amal-joy-eee/forward-converter-design/efficiency.jpg

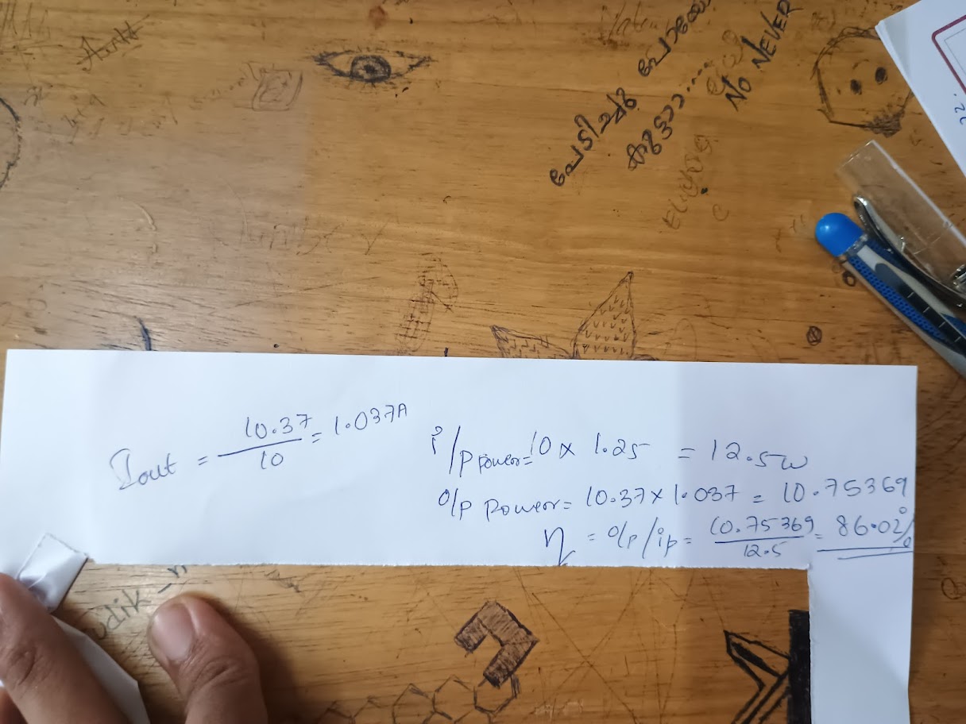
efficiency.jpg
