amal-joy-eee/forward-converter-design/output voltage on multimeter.jpg

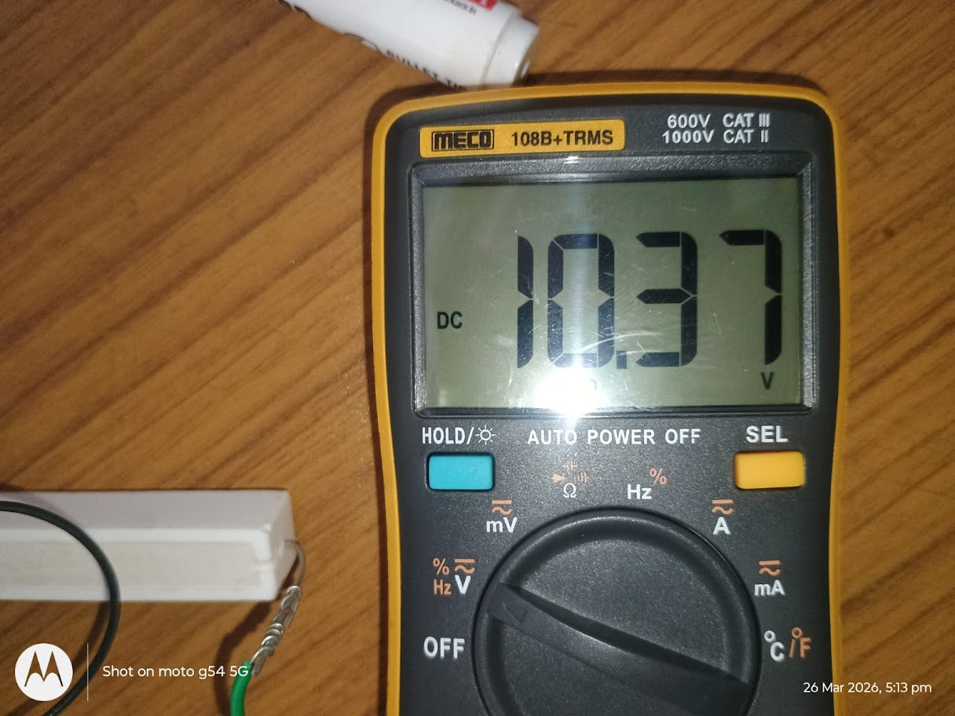
output voltage on multimeter.jpg
