amal-joy-eee/forward-converter-design/honours final  project report Amal 72.pdf

# FORWARD CONVERTER

# DESIGN AND IMPLEMENTATION

## COURSE PROJECT REPORT HNEET409 ANALYSIS OF POWER CONVERTERS

### Submitted by

## Amal Joy Reg No: LTCR24EE142

to

the APJ Abdul Kalam Technological University in partial fulfillment of the requirements for the award of the degree of

Bachelor of Technology in
Electrical and Electronics Engineering

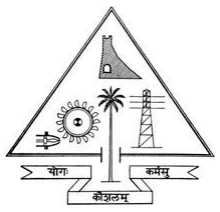
[picture p3: figure]

### Department of Electrical and Electronics Engineering

### Government Engineering College, Thrissur

### MARCH 2026 DEPARTMENT OF ELECTRICAL ENGINEERING

### GOVERNMENT ENGINEERING COLLEGE, THRISSUR

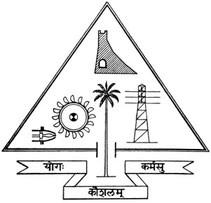
[picture p4: figure]

# CERTIFICATE

### This is to certify that the report entitled “Forward Converter Design and

### Implementation” submitted by Amal Joy (LTCR24EE142) to the APJ

### Abdul Kalam Technological University in partial fulfillment of the requirements for the award of the degree of Bachelor of Technology in

### Electrical and Electronics Engineering is a bonafide record of the project

work carried out under my guidance and supervision.

## This report has not been submitted to any other University or

Institute for any purpose.

ii

## Project Guide Dr. Nakula Narayanan Assistant Professor Dept. of Electrical and Electronics Engineering GEC Thrissur

# ACKNOWLEDGEMENT

## I would like to express my sincere gratitude to the Department of

## Electrical and Electronics Engineering, Government Engineering

## College, Thrissur, for providing me the opportunity to undertake this

## project as part of the course HNEET409 – Analysis of Power

Converters.

## I extend my heartfelt thanks to Dr. Nakula Narayanan, Assistant

## Professor, for his valuable guidance, constant encouragement, and

technical support throughout the project.

## I also thank all faculty members, my friends, and my family for their

support and encouragement.

## 1 Abstract

This report presents the design, simulation, and hardware implementation of a forward converter. The converter is designed to step up an input voltage of 10 V to an output voltage of 15 V with a load resistance of 10 Ω. The design includes transformer design using an EE42/21/15 ferrite core, output filter design, and control using the TL494 PWM controller.
The converter operates at a switching frequency of 10 kHz. A reset winding is employed in the transformer to ensure proper demagnetization of the core, eliminating the need for a snubber circuit. The transformer and output inductor are designed based on practical constraints such as core area, current density, and window utilization.
The complete circuit is simulated using LTspice, and the performance is verified under steady-state conditions. The practical implementation is carried out on a dot board, and key waveforms such as switching frequency, duty cycle, and transformer voltages are verified using a Digital Storage Oscilloscope (DSO).
The experimental results show an output voltage close to the expected value, with minor deviations due to practical non-idealities such as winding resistance, leakage inductance, and component losses. The converter operates at a duty cycle of approximately 38
A comparison between simulation (with practical component values) and hardware results shows good agreement, validating the design approach. The project demonstrates the practical realization of a forward converter and highlights the impact of non-idealities in real-world power electronic systems.

## Contents

1 Abstract | 1
2 Specifications | 4
3 Design Calculations | 4
4 Transformer Design | 5
5 Output Inductor Design | 8
6 Component Selection with Justification | 11

7 Control Circuit | 12
8 LTspice Simulation | 12
9 Hardware Implementation on breadboard | 14
10 Results and Discussion-simulation based | 15
11 Final Hardware Implementation | 15
12 Conclusion | 20

## 2 Specifications

Input Voltage | 10 V
Output Voltage | 15 V
Load Resistance | 10 Ω
Switching Frequency | 10 kHz
Turns Ratio | 1:4
Magnetizing Inductance 1 mH Output Ripple Limit 1%

## 3 Design Calculations

### 3.1 Output Parameters

Io =

Vo
R

=

15
10
= 1.5 A | (1)
Po = Vo × Io = 22.5 W | (2)

### 3.2 Duty Cycle

Vo = D · n · Vin | (3)
15 = D · 4 · 10 | (4)
D = 0.375 | (5)

### 3.3 Output Inductor Design

Assuming 20% ripple current:

∆IL = 0.3 A | (6)

Lo =

Vo(1 − D)
∆ILfs

(7)

=

15(1 − 0.375)
0.3 × 10⁴

(8)

= 3.125 mH | (9)

### 3.4 Output Capacitor Design

Co =

∆IL
8fs∆Vo

(10)

Co =

0.3
8 × 10⁴ × 0.15

=

0.3
12000
= 25, µF | (11)

A capacitor of 470, µF was used in the hardware implementation, as it was readily available. The higher capacitance helps in further reducing the output voltage ripple.

### 3.5 Magnetizing Current

Im =

VinD

Lmfs

(12)

=

10 × 0.375
1 × 10⁻³ × 10⁴

(13)

= 0.375 A | (14)

## 4 Transformer Design

The transformer is designed for a forward converter to operate safely up to a maximum duty cycle of 50%, ensuring that the core does not saturate under worst-case conditions. The design satisfies constraints on flux density, current density, and window utilization.

### 4.1 Core Selection

Core used: EE42/21/15 ferrite core.

### 4.2 Given Specifications

- Input voltage: Vin = 10 V
- Output voltage: Vo = 15 V
- Output current: Io ≈ 1.5 A
- Switching frequency: fs = 10 kHz
- Maximum duty cycle: Dmax = 0.5
- Core: EE42/21/15 ferrite core

– Effective core area: Ae = 180 mm² = 180 × 10⁻⁶ m² – Window area: Aw = 276 mm²

- Maximum flux density: Bm = 0.2 T
- Current density: J = 3.5 A/mm

2

- Window utilization factor: kw = 0.2
- Turns ratio: Ns/Np = 4

### 4.3 Design Calculations

4.3.1 1. Primary Turns

Np =

VinDmax

BmAefs

(15)

Np =

10 × 0.5
0.2 × 180 × 10⁻⁶ × 10⁴
≈ 13.89 | (16)

Np = 14 turns

4.3.2 2. Secondary Turns

Ns = 4 × Np = 56 turns

4.3.3 3. Reset Winding

Nr = Np = 14 turns

4.3.4 4. Flux Density Check

B =

VinDmax

NpAefs

(17)

B =

10 × 0.5
14 × 180 × 10⁻⁶ × 10⁴
≈ 0.198 T | (18)

B < 0.2 T (Safe)

4.3.5 5. Current and Wire Selection

The required conductor cross-sectional area is given by:

aw =

Irms
J

(19)

Primary Winding

Ip,rms = 5.1012 A (Primary RMS Current @ 50% Duty Cycle -from Ltspice simulation) (20)

awp =

5.1012
3.5

≈ 1.457 mm²
(21)

For 22 SWG wire:

aswg 22 = 0.396 mm²
(bare conductor area) | (22)

ap = 4 × 0.396 = 1.584 mm² (23)

1.584 mm² > 1.457 mm²
(Satisfies)
Ip,max = 4 × 1.57 = 6.28 A | (24)

5.1012 A < 6.28 A (Safe)

Secondary Winding

Is,rms = 1.23 A (Secondary RMS Current @ 50% Duty Cycle-from Ltspice simulation) (25)

aws =

1.23
3.5

≈ 0.351 mm²
(26)

as = 0.396 mm²
(27)

0.396 mm² > 0.351 mm²
(Satisfies)

1.23 A < 1.57 A (Safe)

Reset Winding
aswg 25 = 0.203 mm²
(bare conductor area) | (28)
aswg 25 = ar | (29)

Ir,rms = 0.1176 A (Reset Winding RMS Current @ 50% Duty Cycle-from Ltspice simulation) (30)

awr =

0.1176
3.5

≈ 0.0336 mm²
(31)

ar = 0.203 mm²
(32)

0.203 mm² ≫ 0.0336 mm²
(Safe)

0.1176 A < 0.8 A (Safe)

### 4.3.6 Wire Selection

- Primary: 4 × 22 SWG (litz equivalent)
- Secondary: 22 SWG
- Reset: 25 SWG (bifilar)

4.3.7 6. Window Utilization Check

Acu = Npap + Nsas + Nrar | (33)
Acu = (14 × 1.584) + (56 × 0.396) + (14 × 0.203) | (34)

Acu = 22.176 + 22.176 + 2.842 ≈ 47.19 mm²
(35)

Awkw = 276 × 0.2 = 55.2 mm²
(36)

47.19 < 55.2 (Winding fits)

### 4.4 Final Design Summary

Parameter | Value
Core Primary turns Secondary turns Reset turns Turns ratio Flux density Primary wire Secondary wire Reset wire | EE42/21/15 14 turns 56 turns 14 turns 1:4 0.198 T 4 × 22 SWG 22 SWG 25 SWG (bifilar)

### 4.5 Design Remarks

The transformer is designed for a maximum duty cycle of 50% to ensure safe operation under worst-case conditions. The selected number of primary turns limits the flux density below 0.2 T, preventing core saturation.
The conductor sizes are selected based on a current density of 3.5 A/mm

2
, and all
windings satisfy this criterion. Manufacturer current ratings further confirm safe operation under maximum load.
The transformer is implemented without an air-gap, as it is intended for energy transfer. The reset winding ensures proper demagnetization of the core. The window utilization confirms that the winding arrangement is physically realizable.

### 4.6 Practical Implementation and Observations

The primary turns were increased to 17 to obtain a primary inductance of 1.01 mH. For a turns ratio of 1:4, 68 turns were required on the secondary. However, due to window area limitation, only 63 turns could be wound, resulting in a measured secondary inductance of 9.34 mH.
The reset winding was implemented using bifilar winding with the primary, ensuring equal inductance and proper core demagnetization.
Winding | Turns | Measured Inductance
Primary Secondary Reset | 17 63 17 | 1.01 mH 9.34 mH 1.01 mH

Table 1: Practical Winding Details

## 5 Output Inductor Design

The output inductor is designed to meet the required inductance while satisfying constraints on flux density, current density, and window utilization.

### 5.1 Given Specifications

- Inductance: L = 3.125 mH
- RMS current: Irms = 1.3175 A
- Peak current: Im = 1.5 A
- Core: E42/21/15 ferrite core

– Effective core area: Ae = 180 mm²

– Window area: Aw = 276 mm²

- Maximum flux density: Bm = 0.25 T
- Wire used: 2 strands of 22 SWG (litz equivalent)

– Single strand area: 0.326 mm²

– Effective copper area: aw = 0.652 mm²

- Maximum current density: J < 3.5 A/mm

2

- Maximum window fill factor: kw ≤ 0.3
- Relative permeability: µr = 2200
- Permeability of free space: µ0 = 4π × 10⁻⁷ H/m

### 5.2 Design Calculations

### 5.2.1 Number of Turns

N =

LIm

BmAe

(37)

N =

3.125 × 10⁻³ × 1.5
0.25 × 180 × 10⁻⁶
≈ 104.17 | (38)

N = 105 turns

### 5.2.2 Air-gap Length

lg =

µ0N²Ae
L

(39)

lg =

4π × 10⁻⁷ × (105)² × 180 × 10⁻⁶ 3.125 × 10⁻³

≈ 0.80 mm | (40)

lg ≈ 0.80 mm

### 5.2.3 Window Fill Factor

kw =

N aw
Aw

(41)

kw =

105 × 0.652
276
≈ 0.248 | (42)

kw < 0.3 (Satisfied)

### 5.2.4 Current Density

J =

Irms
aw

(43)

J =

1.3175
0.652

≈ 2.02 A/mm

2
(44)

J < 3.5 (Satisfied)

### 5.2.5 Fringing Condition

p
Ae =

√
180 ≈ 13.4 mm

lg = 0.80 mm ≪ 13.4 mm

### 5.2.6 Reluctance Condition

0.065 mm ≪ 0.80 mm

### 5.3 Final Design Summary

Parameter | Value
Inductance Number of turns Air-gap length Core Wire Effective copper area Fill factor Current density | 3.125 mH 105 turns 0.80 mm E42/21/15 2 × 22 SWG 0.652 mm² 0.248 2.02 A/mm²

### 5.4 Practical Implementation and Observations

The inductor was practically wound with a total of 107 turns arranged in 5 layers. Due to practical limitations, the air-gap was not set with high precision. As a result, the measured inductance of the output inductor was approximately 4.67 mH, which is higher than the designed value of 3.125 mH.
Since a higher inductance results in reduced output current ripple in the forward converter, the obtained value is acceptable and does not adversely affect the performance. Therefore, the designed inductor was retained without further modification.

## 6 Component Selection with Justification

### 6.1 Switch (MOSFET)

Device used: IRF540N
The IRF540N MOSFET is selected due to its high current handling capability and sufficient voltage rating (100 V), making it suitable for low-voltage, high-current applications. It also offers low ON resistance, reducing conduction losses.

### 6.2 Diode

Device used: MBR20100CT (Schottky diode)
A Schottky diode is chosen due to its low forward voltage drop and fast switching characteristics. This improves efficiency and reduces switching losses in the converter.

### 6.3 Output Capacitor

Value used: 470 µF
The capacitor value is selected higher than the calculated minimum (375 µF) to ensure that the output voltage ripple remains within 1% under practical conditions.

### 6.4 Output Inductor

Value designed: 3.125 mH
pratical obtained value:4.37mH
The inductor is designed to limit the ripple current to 20% of the load current, ensuring continuous conduction mode (CCM) and reduced output voltage ripple.

### 6.5 Transformer Core

Core used: EE42/21/15 ferrite core
The EE42 core is selected for its adequate power handling capability ( 20–50 W range) and suitability for operation at 10 kHz with low core losses.

### 6.6 Winding Strategy

- Primary winding uses multiple parallel wires (litz equivalent) to reduce skin effect losses at switching frequency.
- Bifilar winding is used for the reset winding to ensure tight coupling and effective core reset.
- Secondary uses thicker wire to handle higher current.

### 6.7 Controller

Device used: TL494 PWM controller
The TL494 is selected due to its built-in oscillator, error amplifier, and PWM control features, making it suitable for fixed-frequency switching applications.

### 6.8 Load Resistor

Value: 10 Ω, 20 W
The resistor is rated higher than the calculated power dissipation (22.5 W peak handling considered) to ensure safe operation and thermal reliability.

## 7 Control Circuit

PWM controller used: TL494
Switching frequency set to 10 kHz.

### 7.1 schematic of TL494 circuit

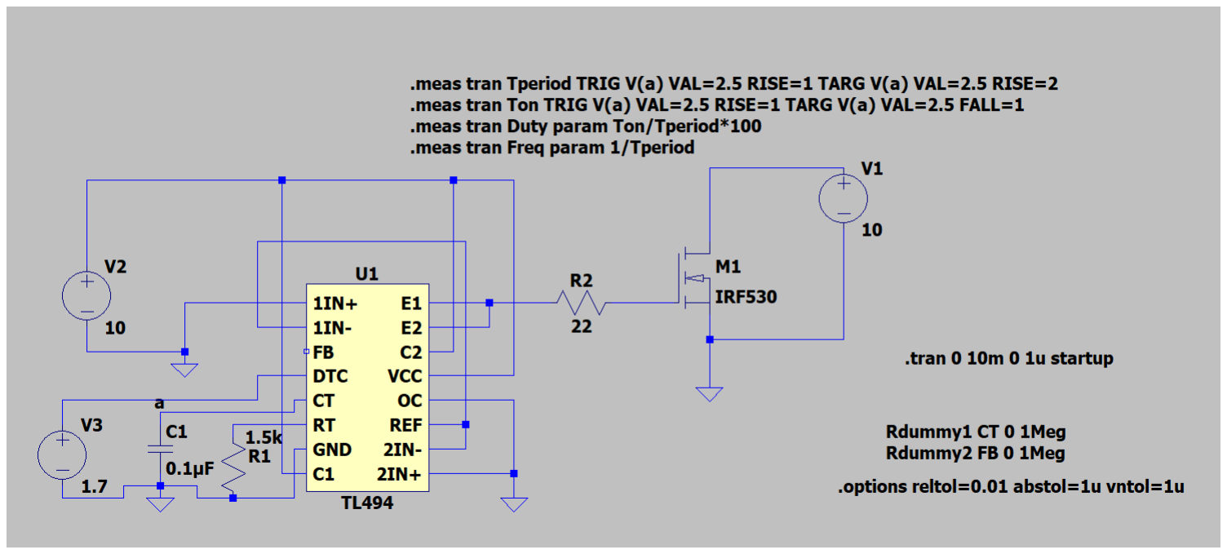
[picture p5: figure]

Figure 1: reference circuit for pulse generation

## 8 LTspice Simulation

### 8.1 Circuit Diagram

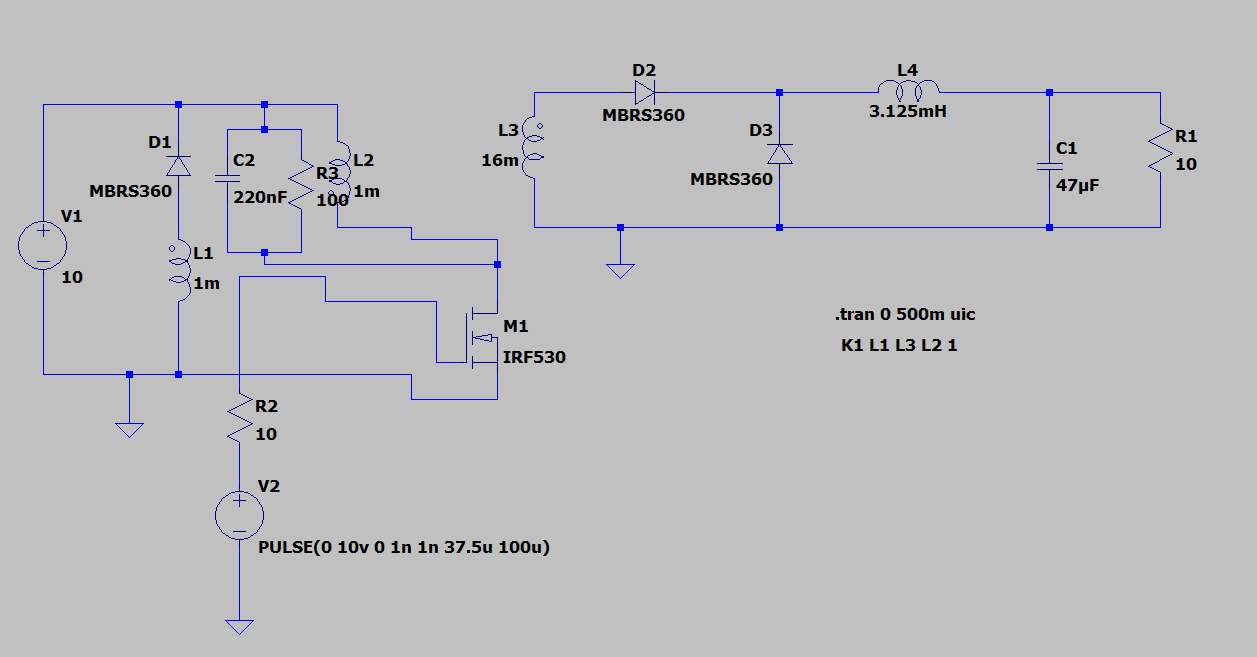
[picture p6: figure]

Figure 2: LTspice Schematic

### 8.2 Output Voltage

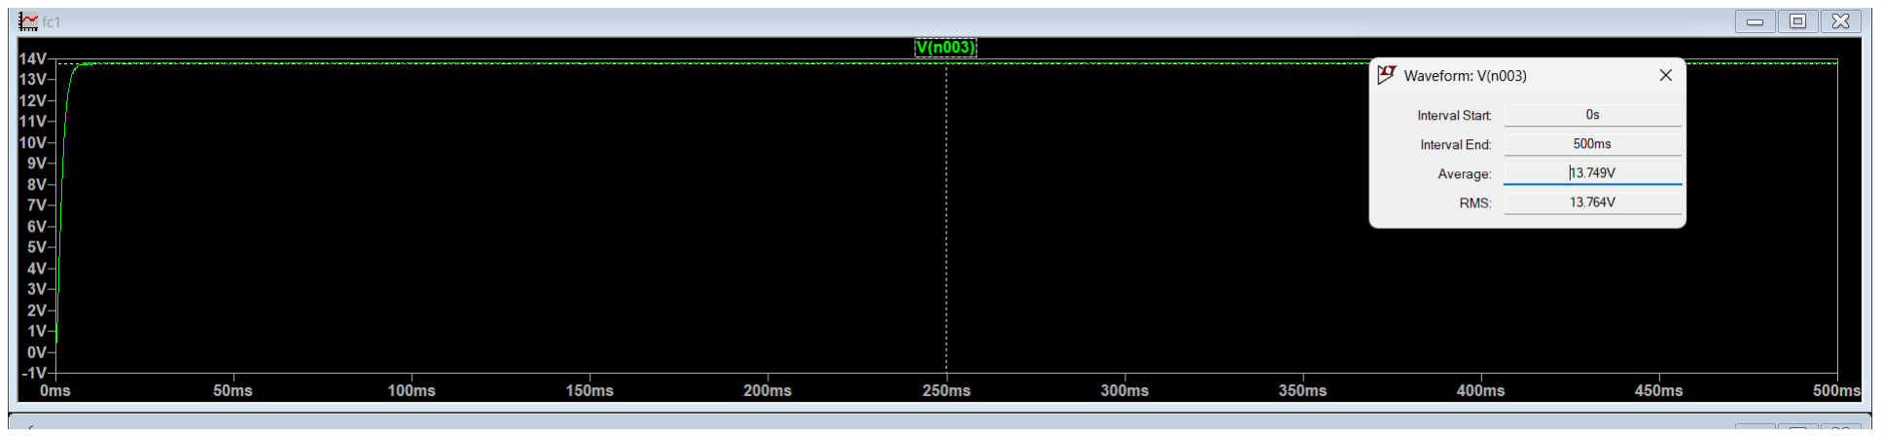
[picture p7: figure]

Figure 3: Output Voltage

### 8.3 Output Ripple

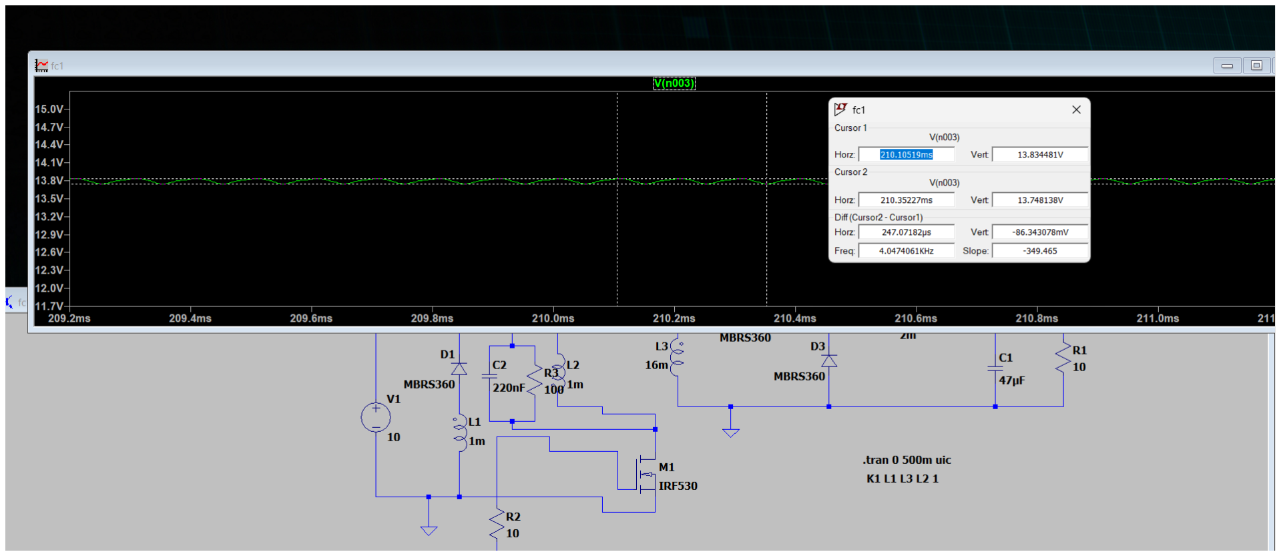
[picture p8: figure]

Figure 4: Output Ripple

### 8.4 Inductor Current

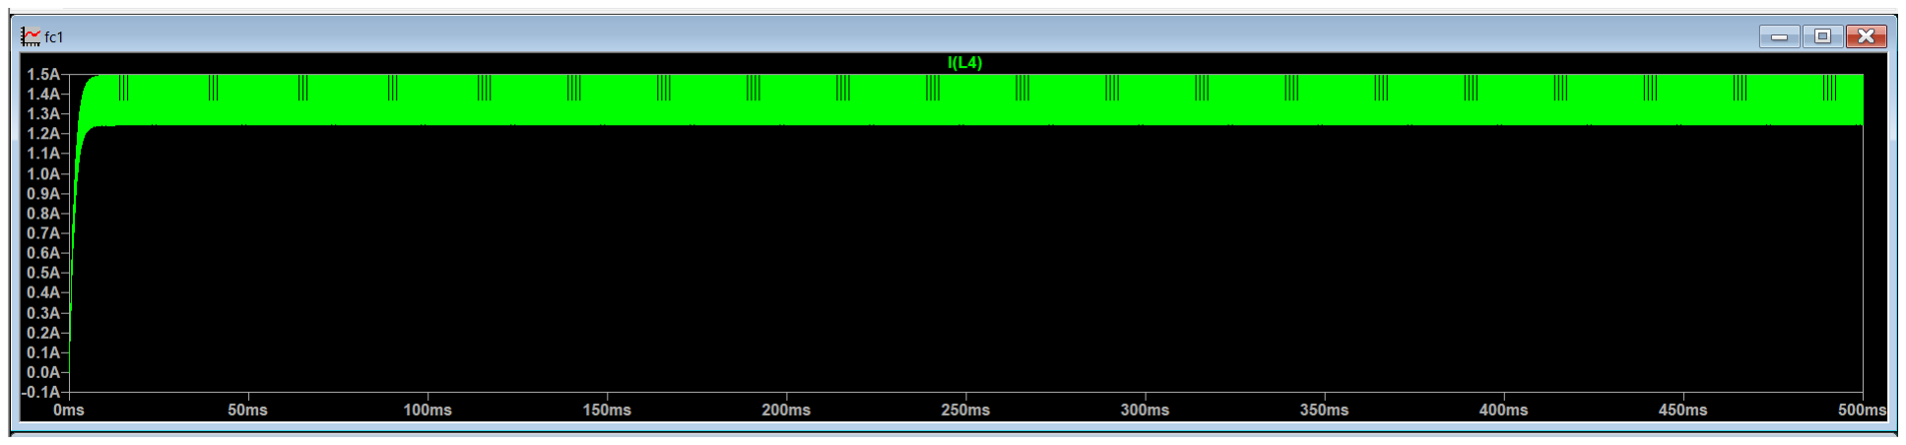
[picture p9: figure]

Figure 5: Inductor Current

### 8.5 inductor Ripple

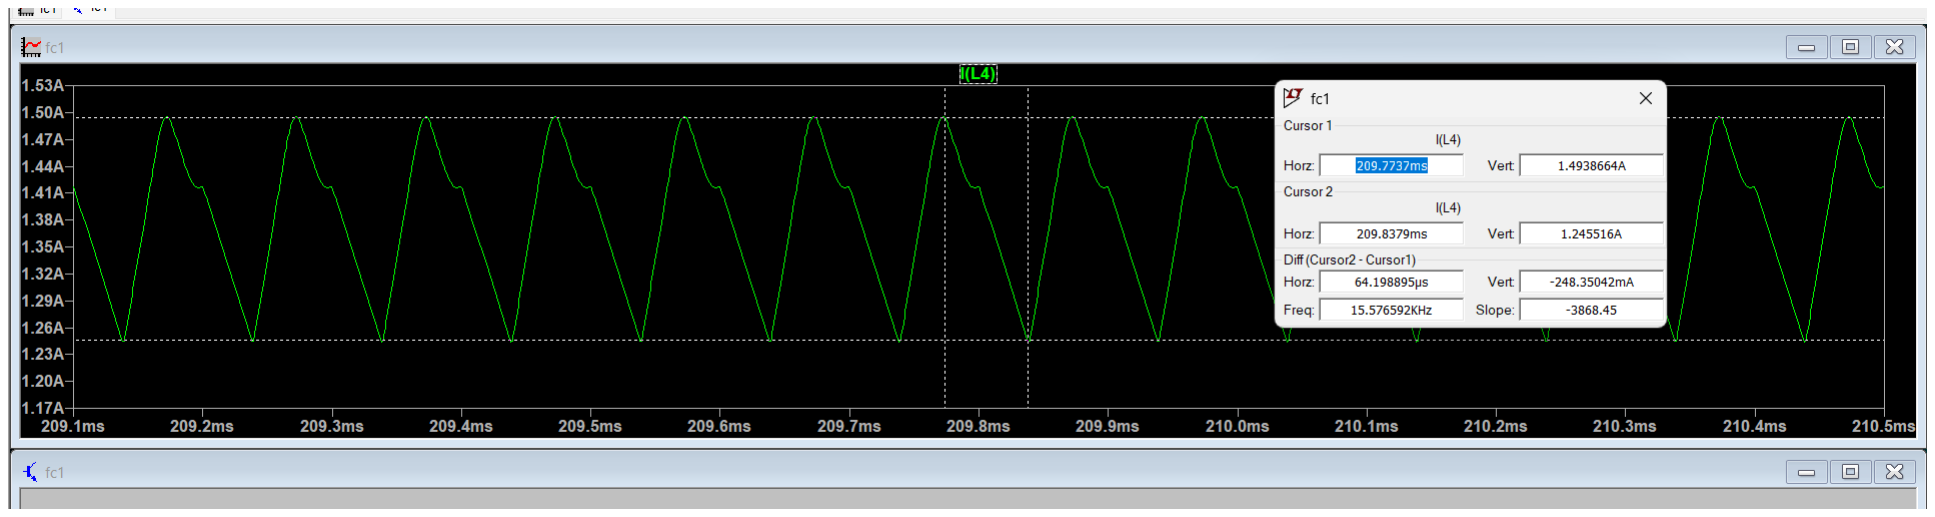
[picture p10: figure]

Figure 6: inductor Ripple

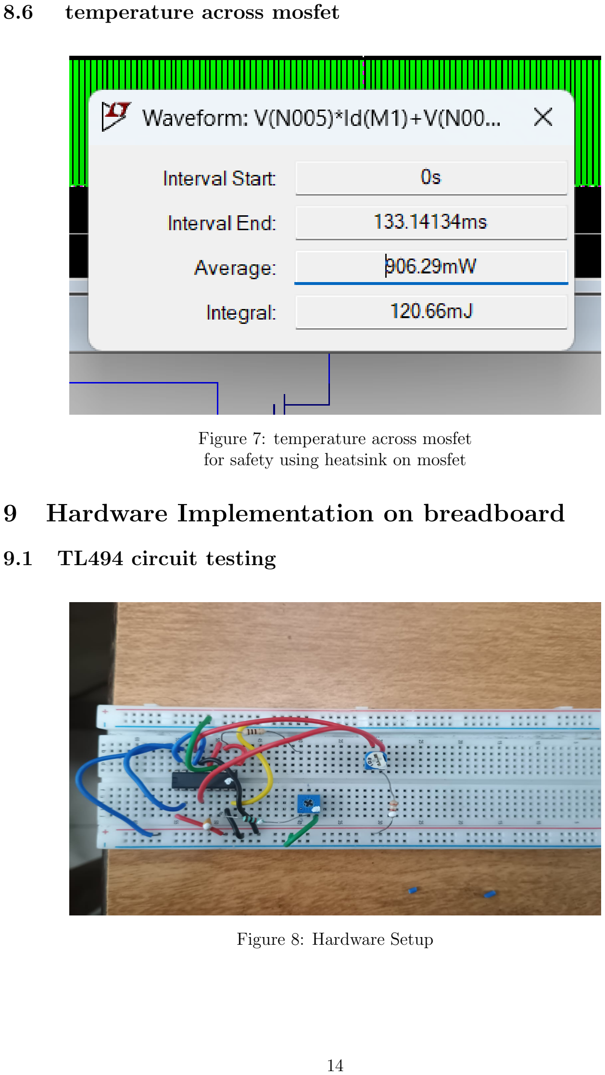
[picture p11: page 17]

### 8.6 temperature across mosfet

Figure 7: temperature across mosfet for safety using heatsink on mosfet

## 9 Hardware Implementation on breadboard

### 9.1 TL494 circuit testing

Figure 8: Hardware Setup

### 9.2 DSO Waveforms

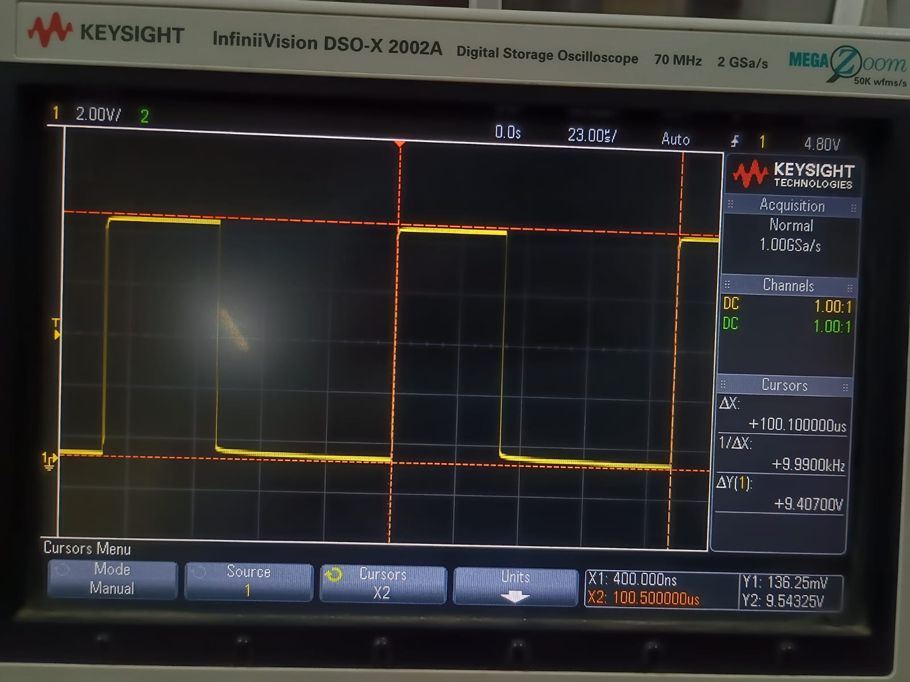
[picture p12: figure]
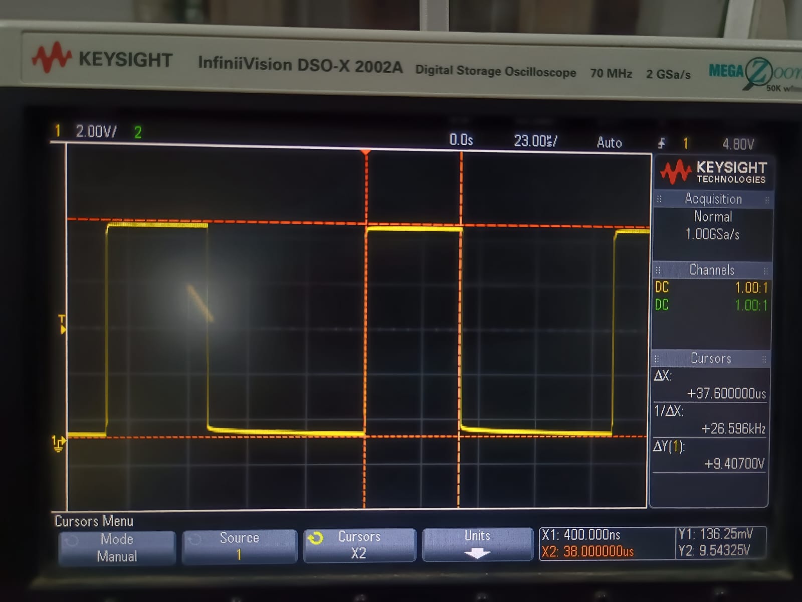
[picture p13: figure]

(a) Waveform 1 | (b) Waveform 2

Figure 9: Experimental Waveforms

## 10 Results and Discussion-simulation based

- Output voltage obtained is approximately 15 V.
- Ripple is within the 1% design limit.
- Transformer reset is successful using reset winding.
- Minor deviations due to non-ideal components and leakage inductance.

## 11 Final Hardware Implementation

### 11.1 Forward Converter Prototype

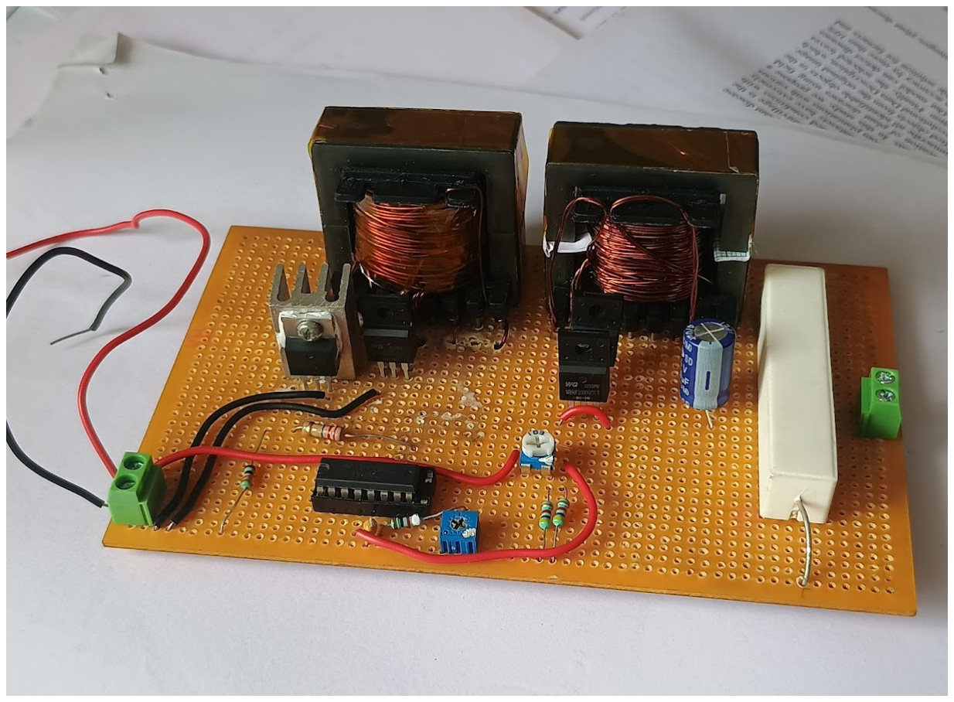
[picture p14: figure]

Figure 10: Front View

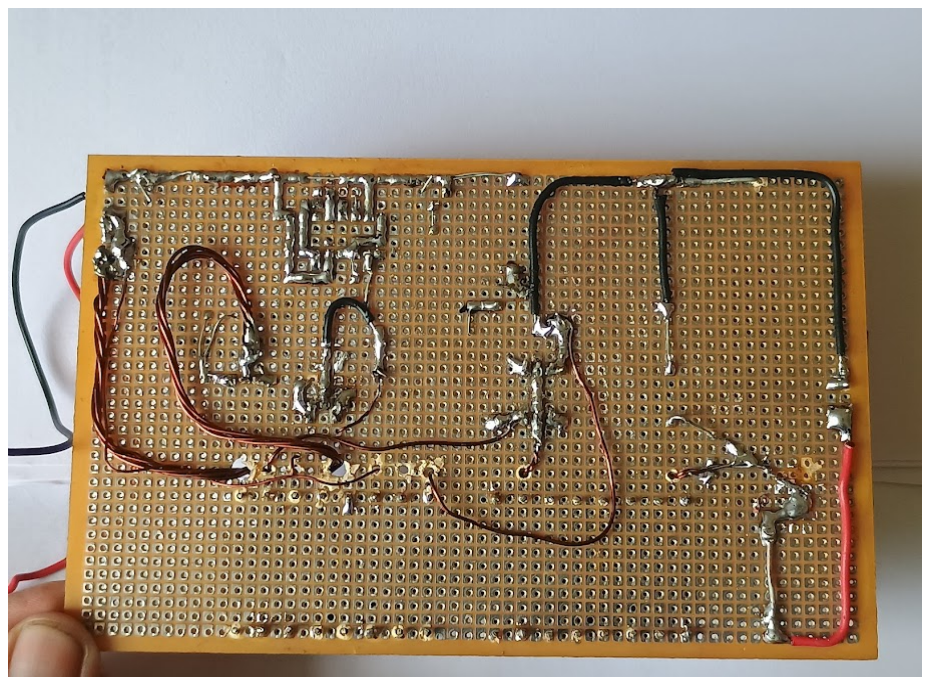
[picture p15: figure]

Figure 11: Back View (Solder Side)

Forward Converter Implemented on Dot Board
The forward converter was implemented on a dot board using discrete components. Care was taken to minimize wiring length and ensure proper grounding to reduce noise and switching spikes.

### 11.2 Input Power Measurement

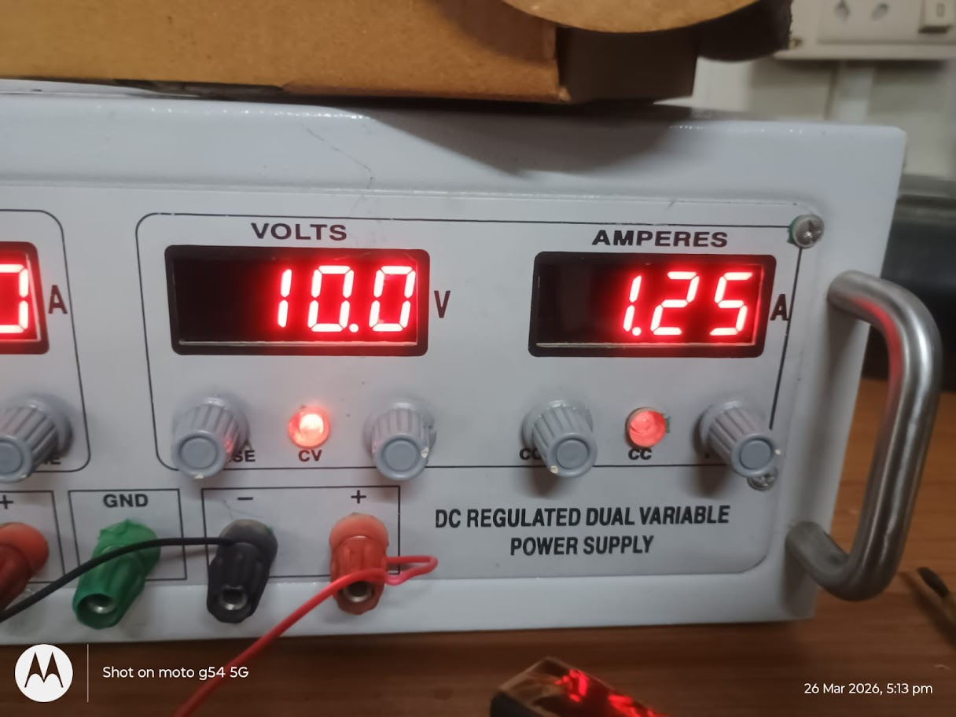
[picture p16: figure]

Figure 12: Input Supply Showing 10 V and 1.25 A

The converter draws approximately 1.25 A from a 10 V DC supply, corresponding to an input power of approximately 12.5 W under load conditions.

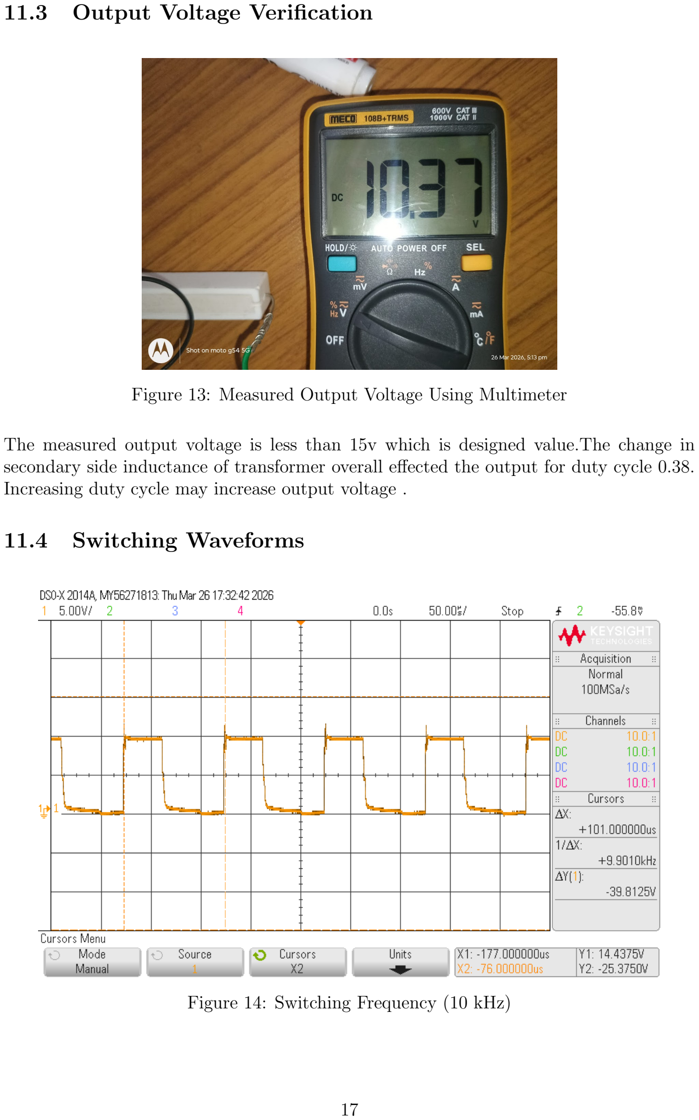
[picture p17: page 20]

### 11.3 Output Voltage Verification

Figure 13: Measured Output Voltage Using Multimeter

The measured output voltage is less than 15v which is designed value.The change in secondary side inductance of transformer overall effected the output for duty cycle 0.38. Increasing duty cycle may increase output voltage .

### 11.4 Switching Waveforms

Figure 14: Switching Frequency (10 kHz)

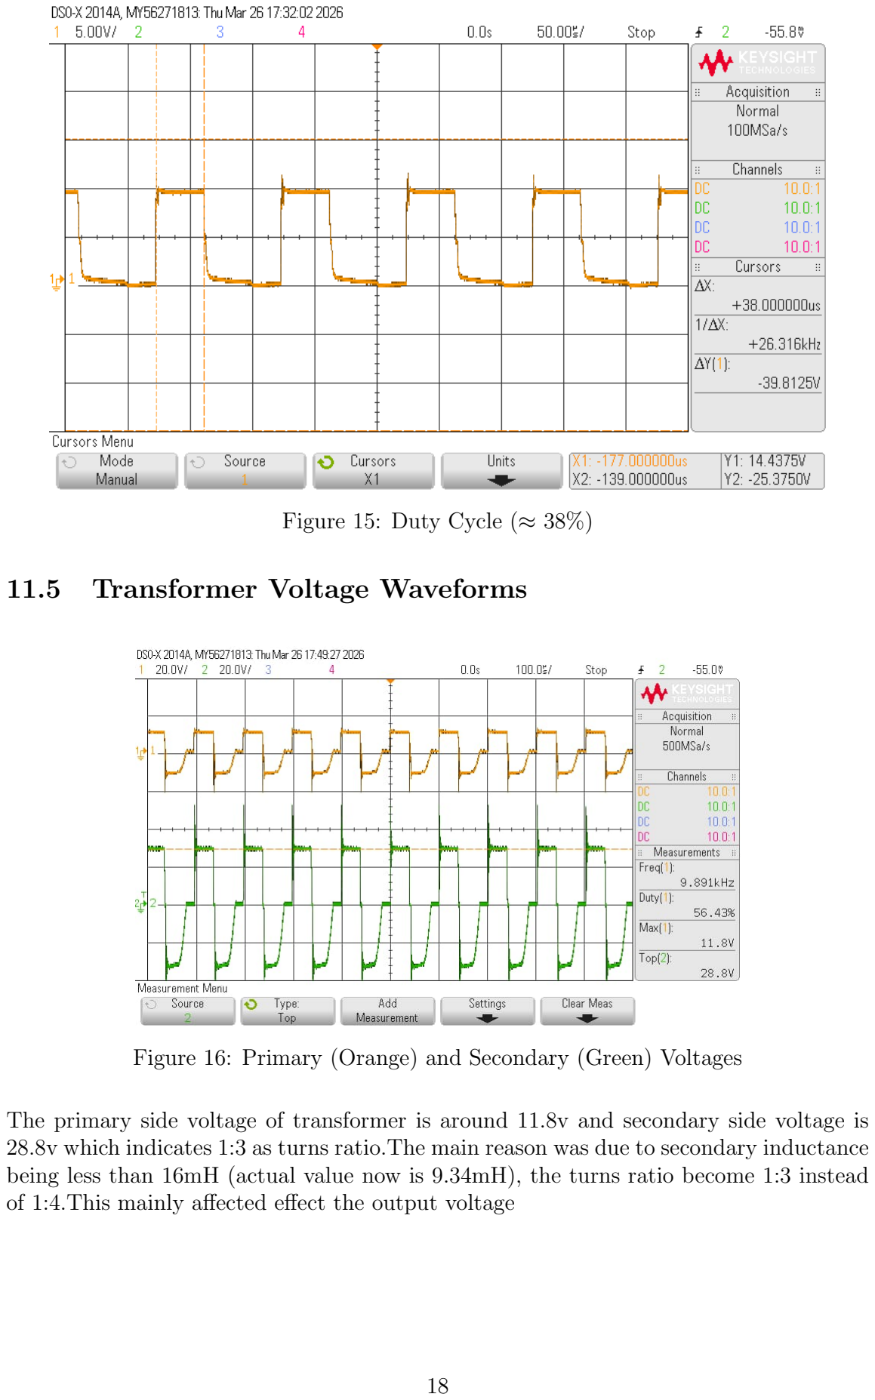
[picture p18: page 21]

Figure 15: Duty Cycle (≈ 38%)

### 11.5 Transformer Voltage Waveforms

Figure 16: Primary (Orange) and Secondary (Green) Voltages

The primary side voltage of transformer is around 11.8v and secondary side voltage is 28.8v which indicates 1:3 as turns ratio.The main reason was due to secondary inductance being less than 16mH (actual value now is 9.34mH), the turns ratio become 1:3 instead of 1:4.This mainly affected effect the output voltage

### 11.6 LTspice Schematic (Practical Values)

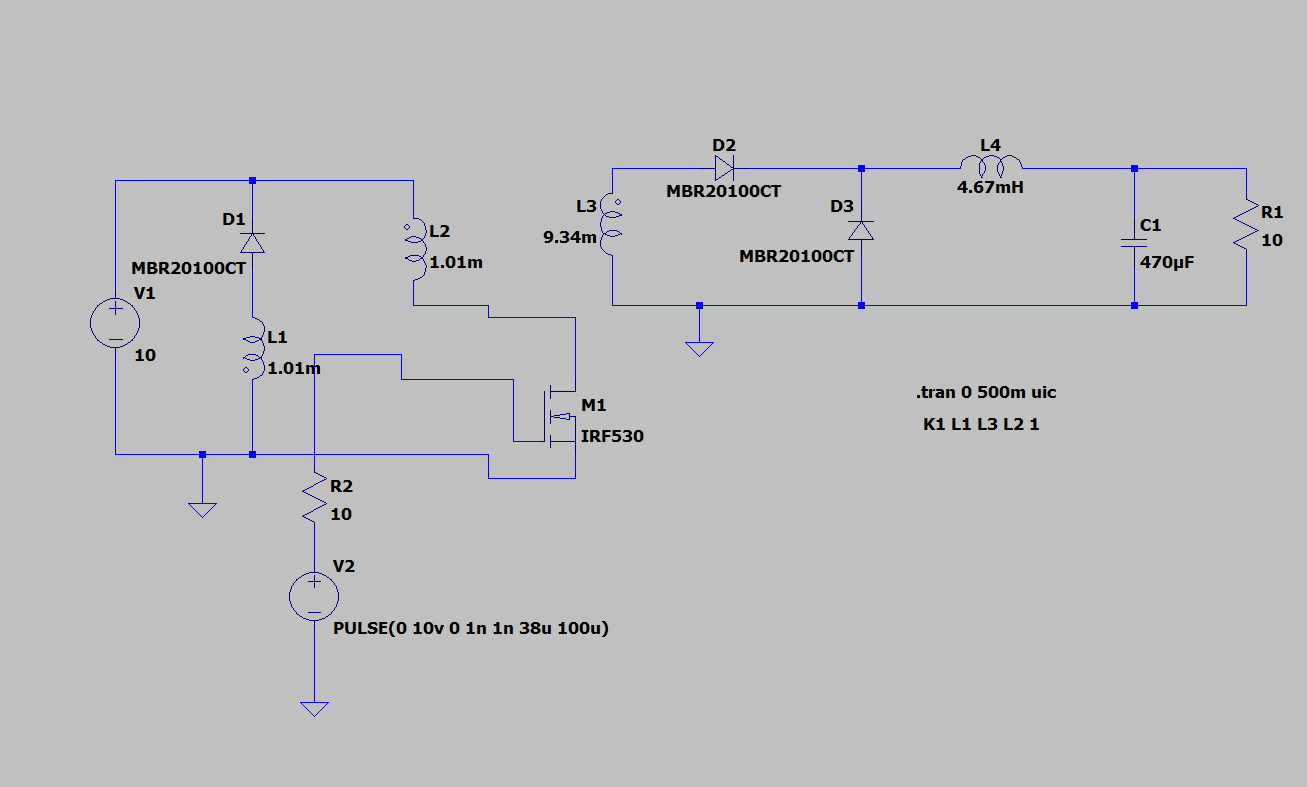
[picture p19: figure]

Figure 17: LTspice Circuit Using Measured Practical Values

### 11.7 Output Voltage (Practical Simulation)

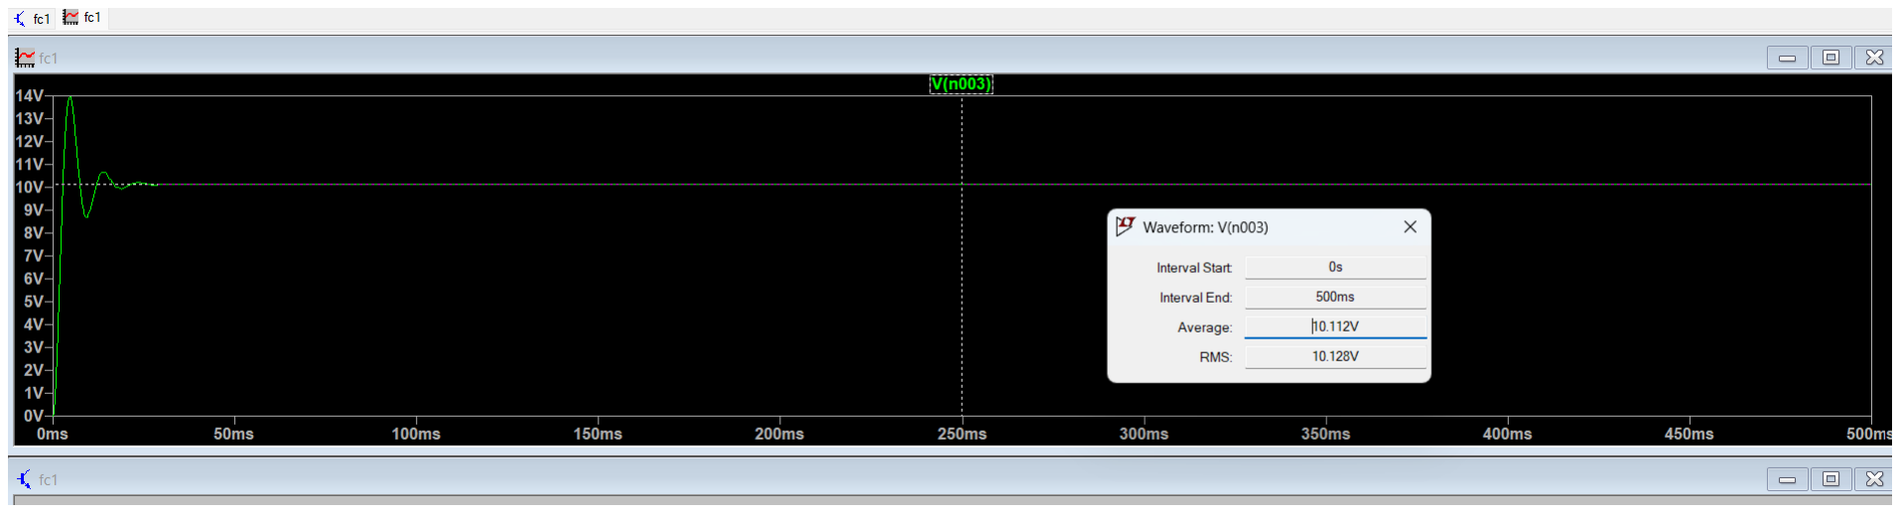
[picture p20: figure]

Figure 18: Simulated Output Voltage with Practical Values

Included inductance values of both the transformer and output inductor, Esr value of inductor( measured around 0.6ohms) is also added and then simulated it in Ltspice. The result (output voltage ) is approximately same as practically measured value

### 11.8 Efficiency Calculation

The efficiency of the forward converter is calculated using the measured input and output values.

Vo = 10.37V, | R = 10, Ω | (45)

Po =

V

2
o
R

=

(10.37)²
| 10
| ≈ 10.75W | (46)
Pin = Vin × Iin = 10 × 1.25 = 12.5W | (47)

η =

Po

Pin

× 100 ≈ 86% | (48)

The converter achieves an efficiency of approximately 86%, which is reasonable considering practical losses such as switching losses, diode losses, copper losses, and core losses.

## 12 Conclusion

A forward converter was successfully designed, simulated, and implemented. The hardware results closely match the theoretical and simulation results, validating the design methodology.
The converter operates at a switching frequency of 10 kHz with an output voltage slightly lower than the desired value. This deviation is primarily due to practical limitations in the transformer design. The reduced secondary inductance resulted in an effective turns ratio closer to 1:3 instead of the designed 1:4, which directly affected the output voltage. However, the output voltage can be increased by operating at a higher duty cycle, as the converter is designed to safely operate up to a duty cycle of 50%. The use of a reset winding ensured proper transformer demagnetization, and the selected components provided stable and reliable performance.
The efficiency of the converter was found to be approximately 86%, which is reasonable considering practical losses such as switching losses, diode voltage drops, and parasitic effects.
Overall, the project demonstrates the practical realization of a forward converter and highlights the impact of non-idealities in real-world implementation.

## 13 References

1. L. Umanand, Power Electronics: Essentials and Applications, Wiley India, 2009.

### 2. Muhammad H. Rashid, Power Electronics: Circuits, Devices and

Applications, Pearson Education, 2013.
3. Prof. L. Umanand, NPTEL Lectures on Fundamentals of Power Electronics,

### IISc Bangalore (week 9)
