amal-joy-eee/forward-converter-design/backside of forward converter1.jpg

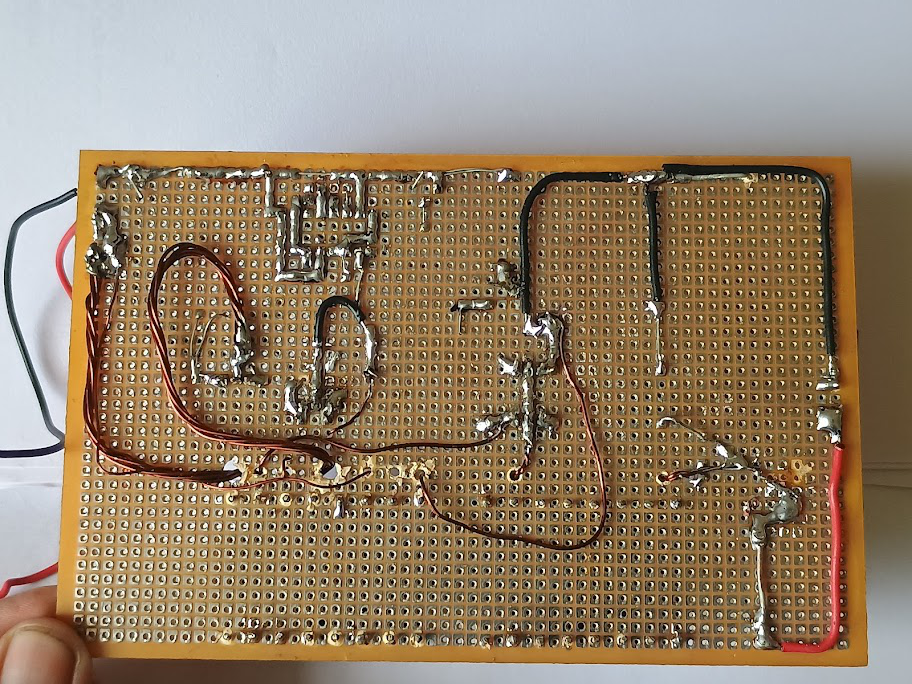
backside of forward converter1.jpg
