amal-joy-eee/forward-converter-design/dso waveform transformer voltages pri and sec.jpg

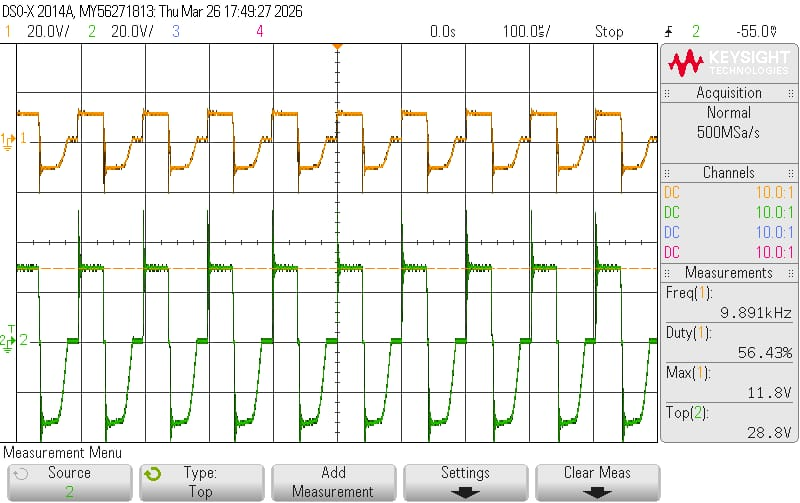
dso waveform transformer voltages pri and sec.jpg
