amal-joy-eee/forward-converter-design/dutycycle 38%.png

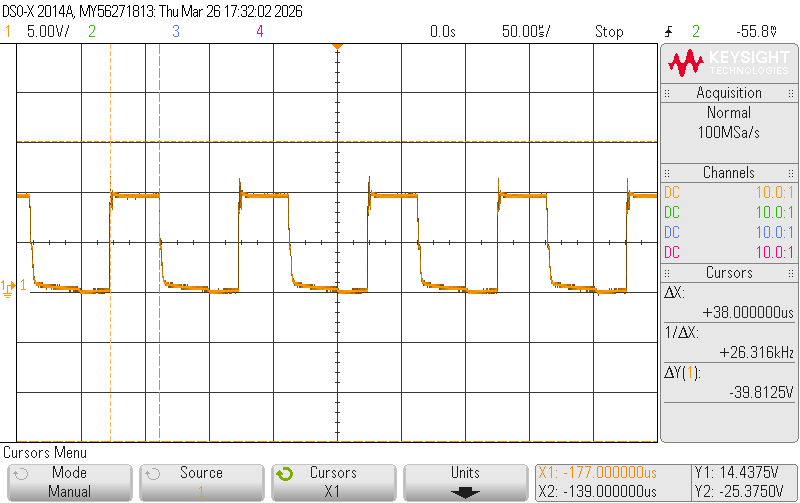
dutycycle 38%.png
