amal-joy-eee/forward-converter-design/o_p voltage practical simulation.png

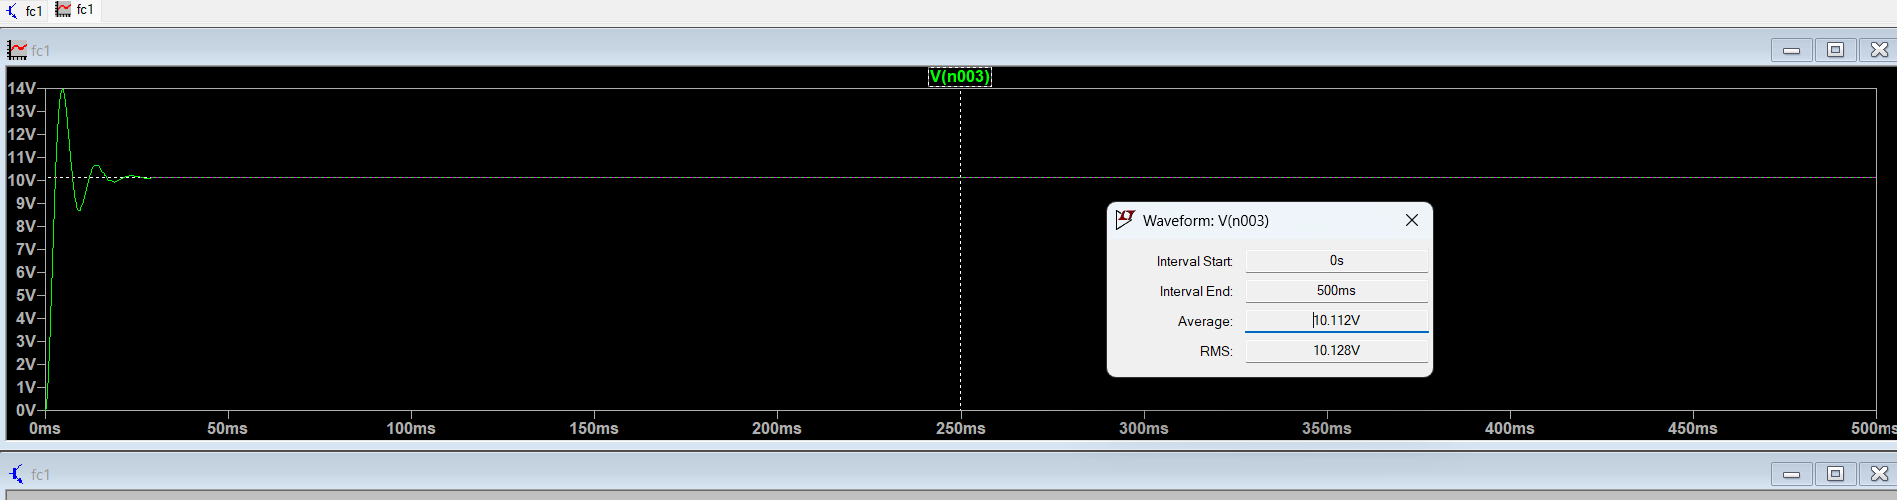
o_p voltage practical simulation.png
