amal-joy-eee/forward-converter-design/scope_1.png

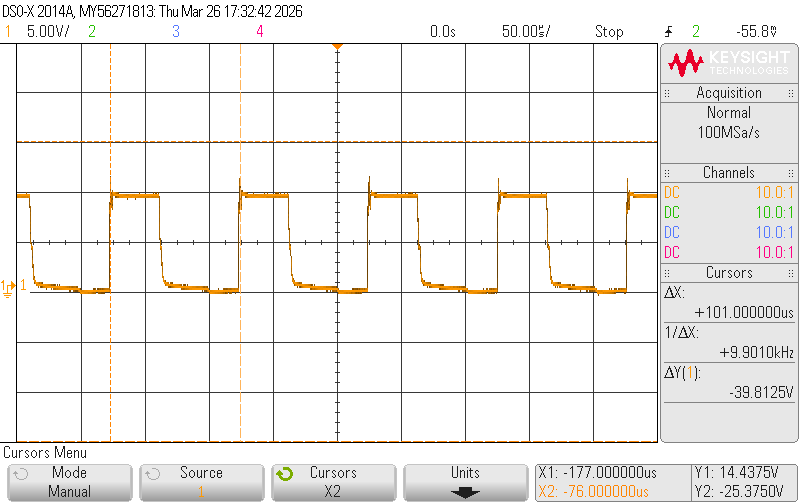
scope_1.png
