amal-joy-eee/forward-converter-design/scope_2.png

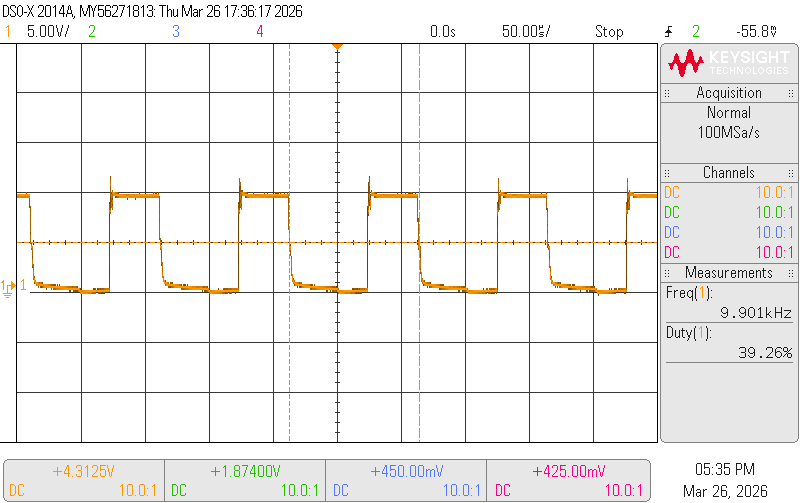
scope_2.png
