amal-joy-eee/forward-converter-design/scope_4.png

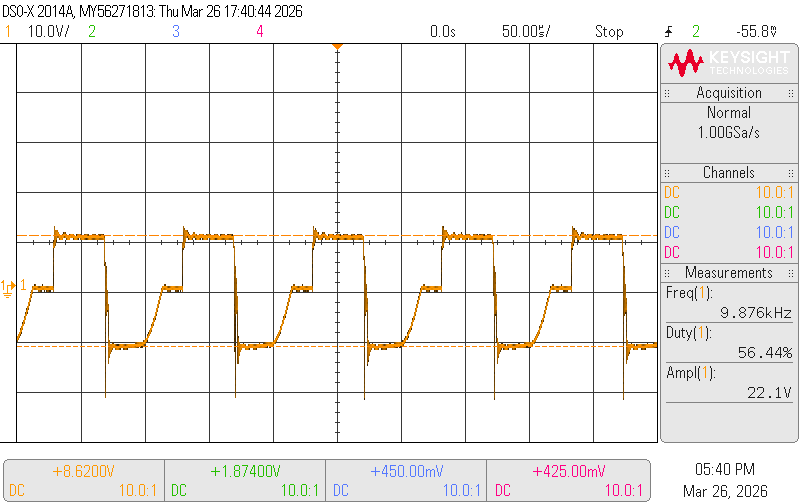
scope_4.png
