amal-joy-eee/forward-converter-design/scope_5.png

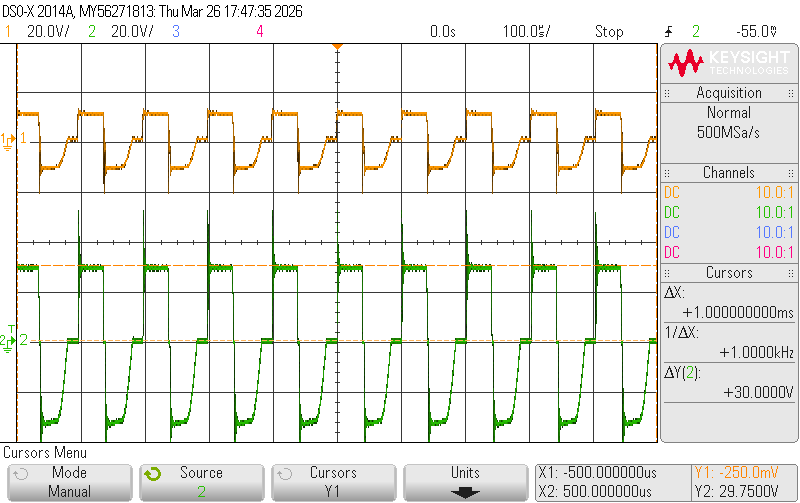
scope_5.png
