amal-joy-eee/forward-converter-design/TL494 reference circuit.png

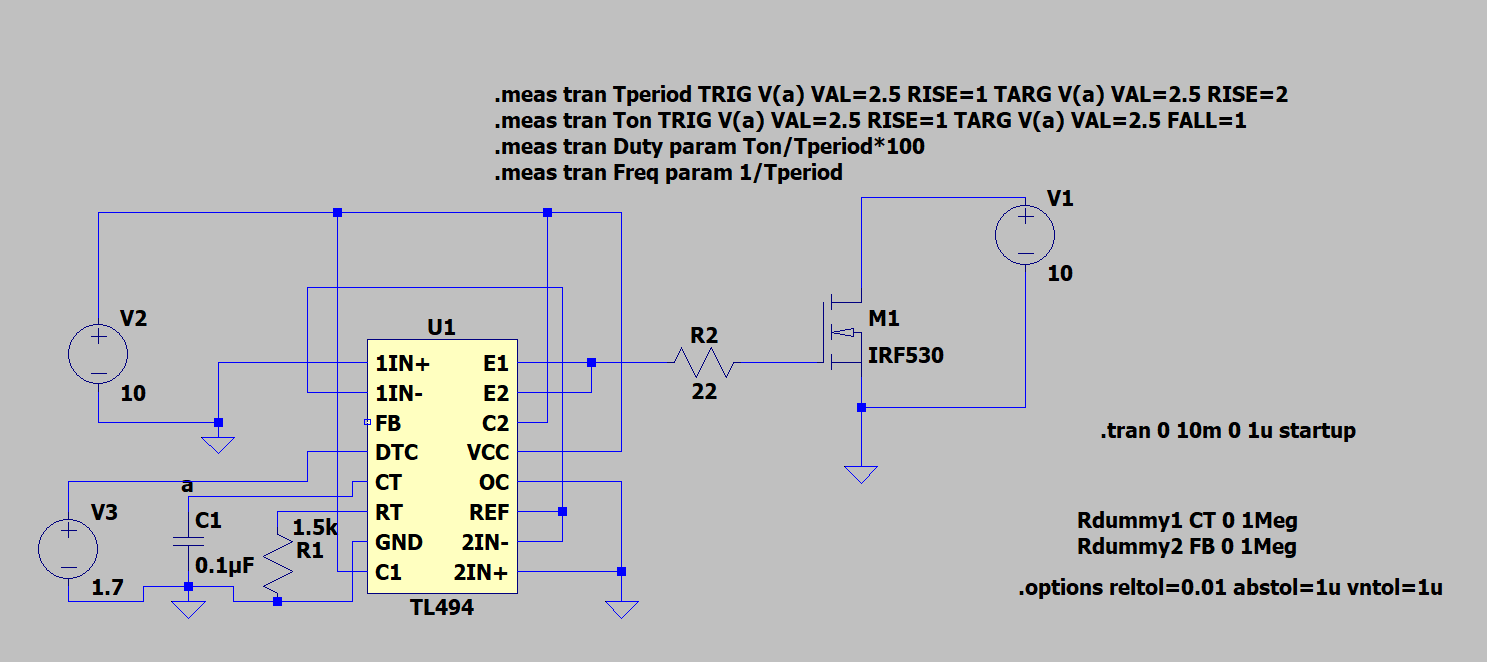
TL494 reference circuit.png
