amal-joy-eee/forward-converter-design/Ltspice_forward_converter_schematic.asc

C1: cap; 470µF
D1: diode; MBR20100CT
D2: diode; MBR20100CT
D3: diode; MBR20100CT
L1: ind; 1.01m
L2: ind; 1.01m
L3: ind; 9.34m
L4: ind; 4.67mH; Rser=0.56
M1: nmos; IRF530
R1: res; 10
R2: res; 10
V1: voltage; 10
V2: voltage; PULSE(0 10v 0 1n 1n 38u 100u)
Named nets: 0
K1 L1 L3 L2 1
.tran 0 500m uic
